robert1269/-magspoof/V1/Hw/KiCad-PCB/MagSpoofTC.kicad_pcb

## KiCad design V1/Hw/KiCad-PCB/MagSpoofTC.kicad_pcb (2019-10-29, an earlier design)

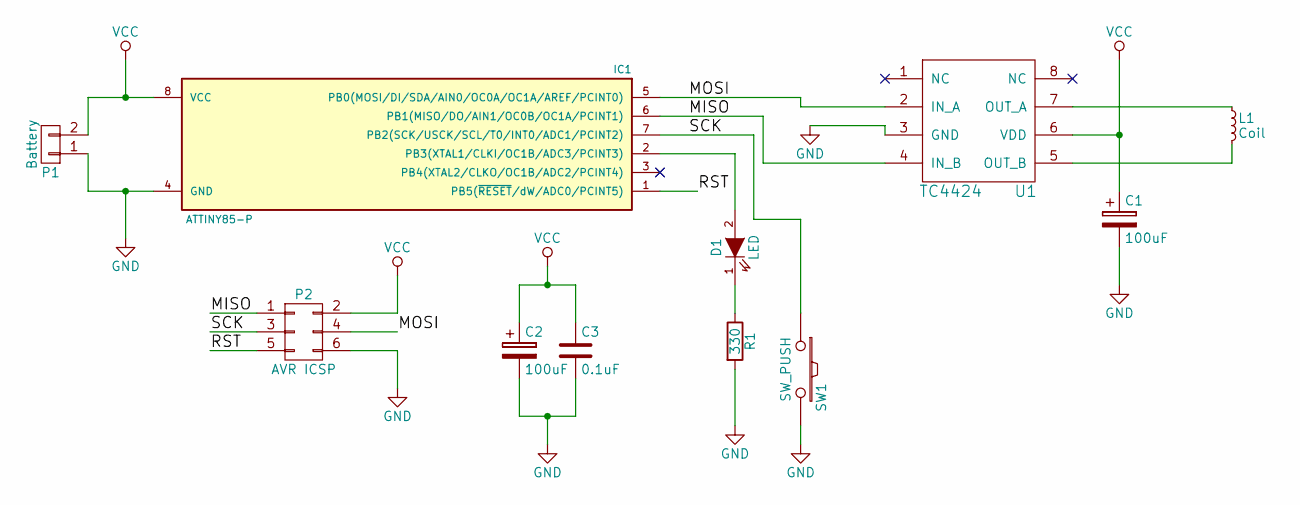
[picture p3: schematic MagSpoofTC.sch, MagSpoof]

Parts:
C1, C2: 100uF; CP_4x5mm
C3: 0.1uF; C_Disc_D3_P2.5
D1: LED; LED-3MM
IC1: ATTINY85-P; DIP-8_W7.62mm_LongPads
L1: Coil; Resistor_Horizontal_RM10mm
P1: Battery; Pin_Header_Straight_1x02
P2: AVR ICSP; Pin_Header_Straight_2x03
R1: 330; Resistor_Horizontal_RM7mm
SW1: SW_PUSH; SW_PUSH_SMD
U1: TC4424; DIP-8_W7.62mm_LongPads

Connections:
/MISO: IC1.6 (PB1(MISO/DO/AIN1/OC0B/OC1A/PCINT1)), P2.1, U1.4 (IN_B)
/MOSI: IC1.5 (PB0(MOSI/DI/SDA/AIN0/OC0A/OC1A/AREF/PCI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), P2.4, U1.2 (IN_A)
/RST: IC1.1 (PB5(~RESET~/dW/ADC0/PCINT5)), P2.5
/SCK: IC1.7 (PB2(SCK/USCK/SCL/T0/INT0/ADC1/PCINT2)), P2.3, SW1.1
GND: C1.2, C2.2, C3.2, IC1.4 (GND), P1.1, P2.6, R1.2, SW1.2, U1.3 (GND)
unnamed: D1.1 (K), R1.1
unnamed: D1.2 (A), IC1.2 (PB3(XTAL1/CLKI/OC1B/ADC3/PCINT3))
unnamed: L1.1, U1.7 (OUT_A)
unnamed: L1.2, U1.5 (OUT_B)
VCC: C1.1, C2.1, C3.1, IC1.8 (VCC), P1.2, P2.2, U1.6 (VDD)

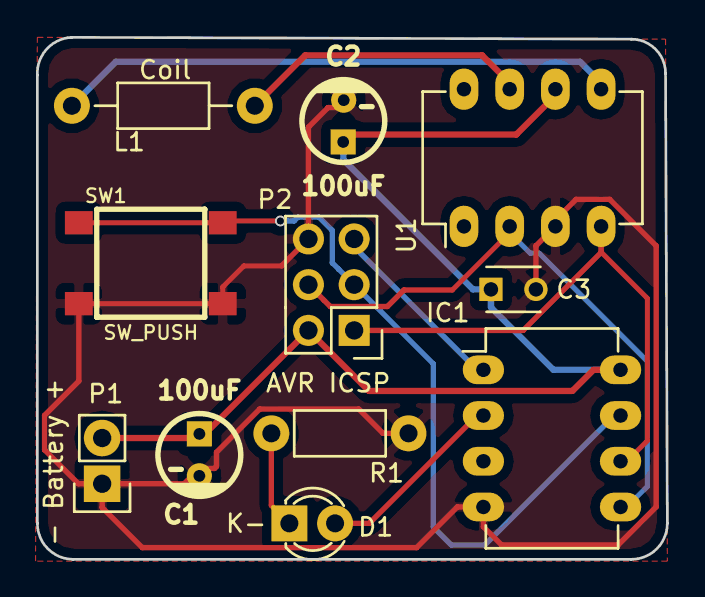
[picture p4: board MagSpoofTC.kicad_pcb from above]

Board: 2 copper layers, 35.0 x 29.0 mm, 11 parts (0 on the bottom side), 10 nets.
