robert1269/-magspoof/V3/Hw/Magspoof_V3 (2).kicad_pcb

## KiCad design V3/Hw/Magspoof_V3 (2).kicad_pcb (2023-02-28, an earlier design)

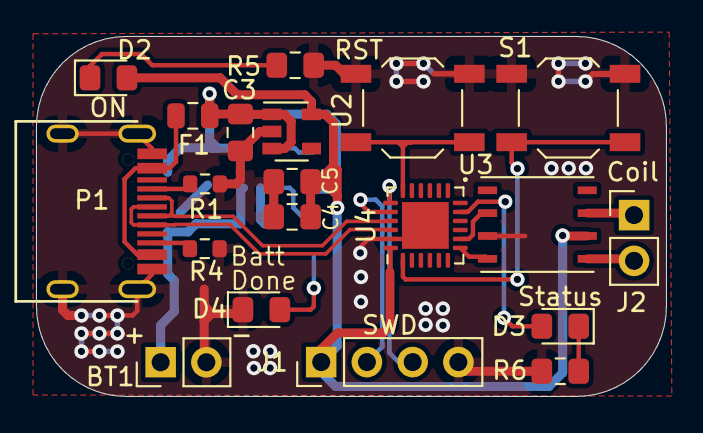
[picture p5: board Magspoof_V3 (2).kicad_pcb from above]

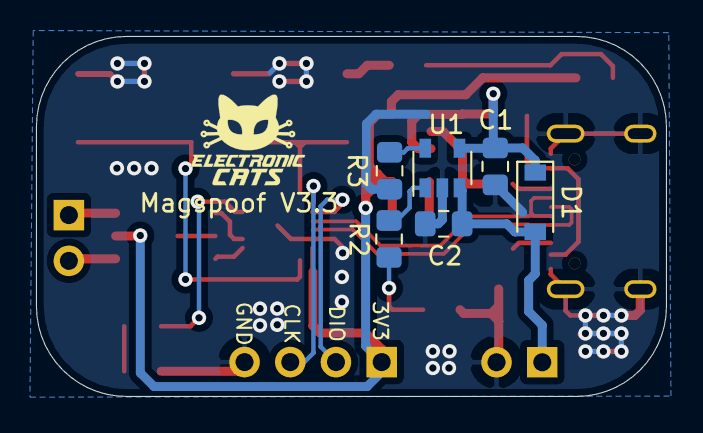
[picture p6: board Magspoof_V3 (2).kicad_pcb from below]

Board: 2 copper layers, 35.0 x 20.0 mm, 26 parts (6 on the bottom side), 23 nets.

Parts:
BT1: Battery_Cell; PinHeader_1x02_P2.54mm_Vertical
C1, C2, C3, C4: 10uF; C_0805_2012Metric_Pad1.15x1.40mm_HandSolder
C5: 0.1uF; C_0805_2012Metric_Pad1.15x1.40mm_HandSolder
D1: MBR120; D_SOD-123
D2: ON; LED_0805_2012Metric_Pad1.15x1.40mm_HandSolder
D3: Status; LED_0805_2012Metric_Pad1.15x1.40mm_HandSolder
D4: CHG; LED_0805_2012Metric_Pad1.15x1.40mm_HandSolder
F1: 0.5A; Fuse_0805_2012Metric
J1: SWD; PinHeader_1x04_P2.54mm_Vertical
J2: Coil; PinHeader_1x02_P2.54mm_Vertical
P1: USB_C_Plug_USB2.0; C393939
R1, R4: 5.1k; R_0603_1608Metric
R2: 470; R_0805_2012Metric_Pad1.15x1.40mm_HandSolder
R3: 2K; R_0805_2012Metric_Pad1.15x1.40mm_HandSolder
R5, R6: 180R; R_0805_2012Metric_Pad1.15x1.40mm_HandSolder
SW1: S1; SW_SPST_TL3342
SW2: RST; SW_SPST_TL3342
U1: MCP73831; SOT-23-5
U2: AP2112K-3.3; SOT-23-5
U3: TC4424; TC4424EMF
U4: ATSAMD11D14A-M; QFN-24-1EP_4x4mm_P0.5mm_EP2.6x2.6mm

Connections:
+3V3: C4.1, C5.1, D2.2, J1.1, U2.5, U3.6, U4.24
+BATT: BT1.1, C2.1, D1.2, U1.3
/D+: P1.A6, U4.22
/D-: P1.A7, U4.21
/IN_A: U3.4, U4.7
/IN_B: U3.2, U4.8
/LED: D3.2, U4.11
/Out_A: J2.1, U3.7
/Out_B: J2.2, U3.5
/RST: SW2.2, U4.18
/SW1: SW1.2, U4.1
/SWCLK: J1.3, U4.19
/SWDIO: J1.2, U4.20
GND: BT1.2, C1.2, C2.2, C3.2, C4.2, C5.2, D4.1, J1.4, P1.A1, P1.S1, R1.1, R3.2, R4.1, R5.2, R6.2, SW1.1, SW2.1, U1.2, U2.2, U3.3, U4.23
unnamed: D2.1, R5.1
unnamed: D3.1, R6.1
unnamed: D4.2, R2.2
unnamed: F1.1, P1.A4
unnamed: P1.A5, R1.2
unnamed: P1.B5, R4.2
unnamed: R2.1, U1.1
unnamed: R3.1, U1.5
VBUS: C1.1, C3.1, D1.1, F1.2, U1.4, U2.1, U2.3
